kenner1-unlv/cs490-lio-slam/docs/assets/future-autonomy-roadmap.png

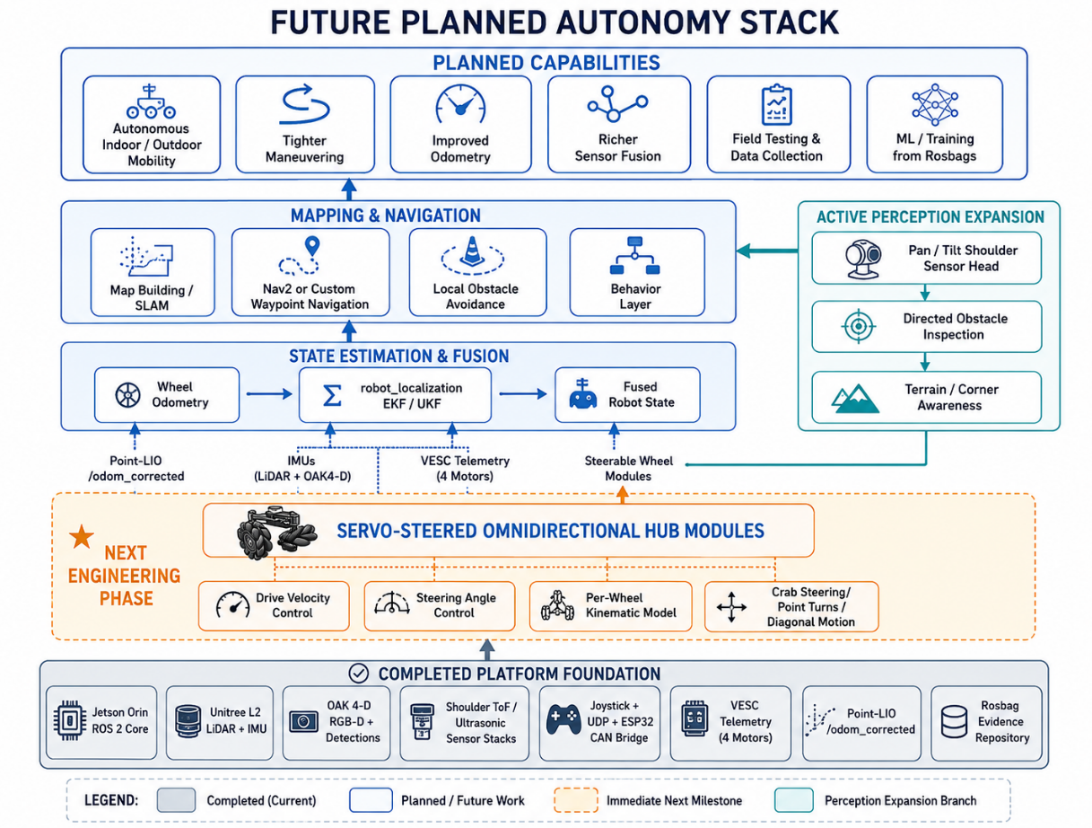
docs/assets/future-autonomy-roadmap.png
