kenner1-unlv/cs490-lio-slam/docs/assets/physical-platform.png

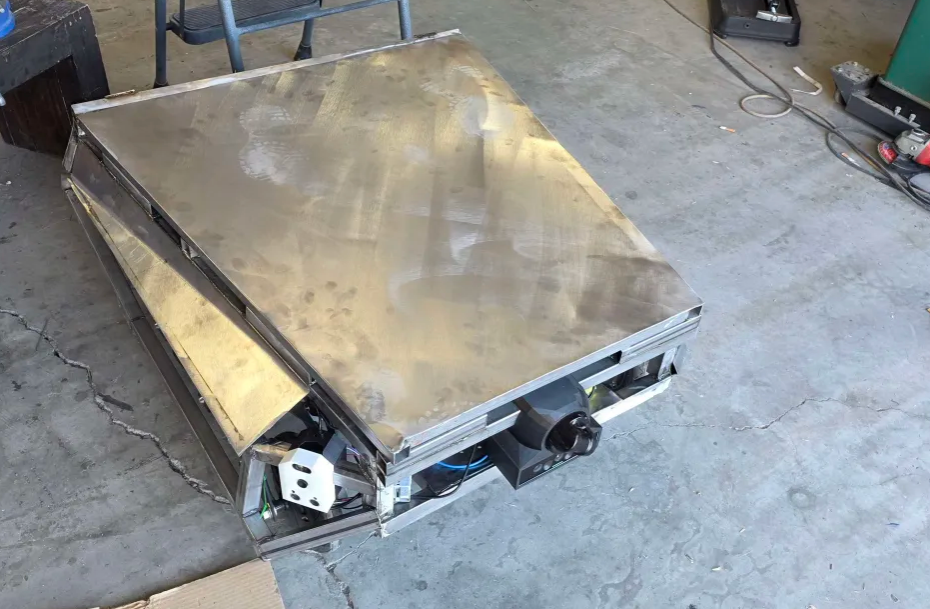
docs/assets/physical-platform.png
