kenner1-unlv/cs490-lio-slam/docs/assets/shoulder-module-cad.png

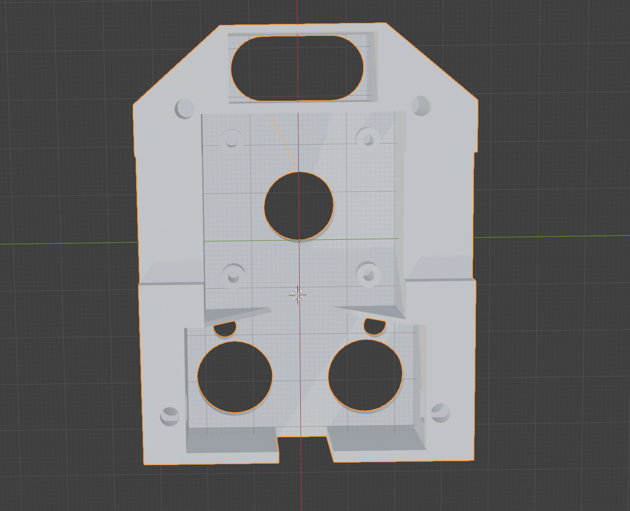
docs/assets/shoulder-module-cad.png
