kenner1-unlv/cs490-lio-slam/docs/test-plan.md

# Next evidence tests

Keep raw bags, scripts, configuration, photos/video, measured reference values and a short result sheet for each run. Before testing, record the hardware revision, wheel/tire condition, battery state, surface, sensor mounts, software commit, date and operator. Report failures and missing topics alongside successes.

| Question | Test and recorded evidence | Result to publish |
| --- | --- | --- |
| How poor was fixed-wheel turning? | Mark a safe flat course; repeat straight runs, 90-degree turns and turn-in-place attempts under manual control. Record commanded motor RPM, four VESC ERPMs, LiDAR/IMU yaw, video, surface and battery state. Use surveyed start/end pose or overhead tracking as ground truth. | Turn completion rate, heading error, turn radius, time, slip and spread across repeated trials. Show the failed runs. |
| Does a different steering design help? | Repeat the same course with the proposed steerable pod or other selected geometry, matching speed, surface and payload. Record steering angle as well as drive state. | Comparative turn and odometry metrics. A CAD rendering alone is not a test result. |
| Are LiDAR and RGB-D spatially aligned? | Use the stationary multi-position target procedure in [perception evaluation](perception-evaluation.md). Record physical measurements and raw sensor headers. | Fitted extrinsic correction, residuals and uncertainty per target position, plus a held-out check. |
| What can the budget L2 actually resolve on this robot? | At known indoor and outdoor distances, target reflectivities and lighting, record raw clouds and IMU with the current and proposed mast mounts. Examine scan bands, per-scan point counts, topic rates, timestamp gaps, valid-return fraction and occlusion. | Coverage and density by range/angle, rate and timing distributions, and failure conditions. Keep any Kalman-filter experiment separate from raw-sensor performance. |
| Is object distance useful? | Place known targets at measured ranges and angles; compare OAK spatial depth and LiDAR returns on the same object. | Signed and absolute range error by distance/angle, detection coverage and missing values. |
| Does object/person tracking work? | Record annotated stationary and moving object/person sequences. Preserve image frames, classes, confidences, 3D positions and persistent IDs if the tracker supplies them. | Detection recall, range error, continuity and identity switches. Label detection and tracking as separate capabilities. |
| Is Point-LIO usable for motion estimation? | Run repeated surveyed straight and turn paths after turning is controllable. Record `/odom_corrected`, raw input, TF and ground truth. Investigate the current 1-to-201,371-message-per-minute spread first. | Translation and heading error, drift per meter, output gaps/rate and failure conditions. |
| Can the integrated system run reliably? | Repeat cold starts and a timed loaded run. Record boot/service logs, topic uptime, packet gaps, CPU/GPU temperature and battery voltage/current. | Start success rate, uptime, worst gaps, power draw and observed faults. Do not claim shift-length endurance until measured. |
| Would an inverted mast improve LiDAR ground and around-body coverage? | Compare current and proposed mast positions on the same stationary targets and manually driven route. Measure ground-return density by distance and direction, near-field blind zones, body occlusion and transform repeatability after remounting. | Side-by-side coverage and calibration results; do not assume higher or inverted placement helps until measured. |
| Could the shoulder modules turn toward a sound? | Prototype a microphone array for direction-of-arrival estimation, a pan/tilt camera and the existing ToF range check. Test known sound-source angles and distances, including noise and false triggers. | Direction error, pointing error, response time, visual identification rate and ToF range error. The current fixed ToF module cannot infer sound direction. |
| Would a NOVA20 line or crossed pair add useful near-field evidence? | Follow the staged [NOVA20 comparison](near-field-sensor-upgrade.md): one bench module, a vertical ground-facing pilot, then a horizontal/cross comparison against existing camera, ToF and ultrasonic observations on surveyed targets. Log each channel and timing separately. | Per-channel error, coverage, detection lead distance, no-return ambiguity, false alarms, latency and incremental value of the second orientation. No collision/drop-off safety claim without vehicle-level validation. |

Autonomous waypoint and obstacle-avoidance tests belong after turning, command arbitration, stop behavior, calibrated frames and state estimation have passed. A joystick topic or motor telemetry alone does not verify planner-driven motion.
