kenner1-unlv/cs490-lio-slam/(commit log)

2026-05-09 Add ESP32 CYD GPS monitor firmware notes
2026-05-09 Add ESP32 CAN bus bridge firmware notes
2026-05-09 Add RDK X5 ROS2 sensor bridge notes
2026-11-08 Document OrinBot robotics integration study
    Turn the CS 490 evidence repository into a portfolio case study with construction figures, bag measurements, perception diagnostics, and honest steering and autonomy limits.
2026-11-08 Add firsthand OrinBot lessons and redesign questions
    Capture the two-person build roles, steering tradeoffs, semester MVP, and proposed LiDAR and shoulder attention experiments in the portfolio study.
2026-11-08 Plan NOVA20 shoulder sensor comparison
    Document the existing shoulder camera and range hardware, a staged line-array evaluation, crossed mounting hypothesis, and the measurements needed before safety or drop-off claims.
2026-11-08 Clarify OrinBot side-sensor redesign scope
    Keep the forward OAK pipeline in the proposed architecture and focus future measurements on side mounts and LiDAR placement.
2026-11-08 Center OrinBot study on semester integration progress
    Present the two-person build as a constrained robotics systems project, foreground the shared sensor and compute stack, and explain the budget LiDAR learning tradeoff while retaining honest autonomy limits.
2026-11-08 Show OrinBot CAD mount iteration
    Add rendered STL examples and source notes for LiDAR, camera, VESC, PoE, and CAN mounts, distinguishing design exports from installed-part evidence.
2026-11-08 Tighten OrinBot portfolio opening
    Lead with one paragraph and two evidence images before the detailed project narrative.
